GijsJackersPXL/Project_ontwerpen/Foto's/Relay board with LCD (3).jpg

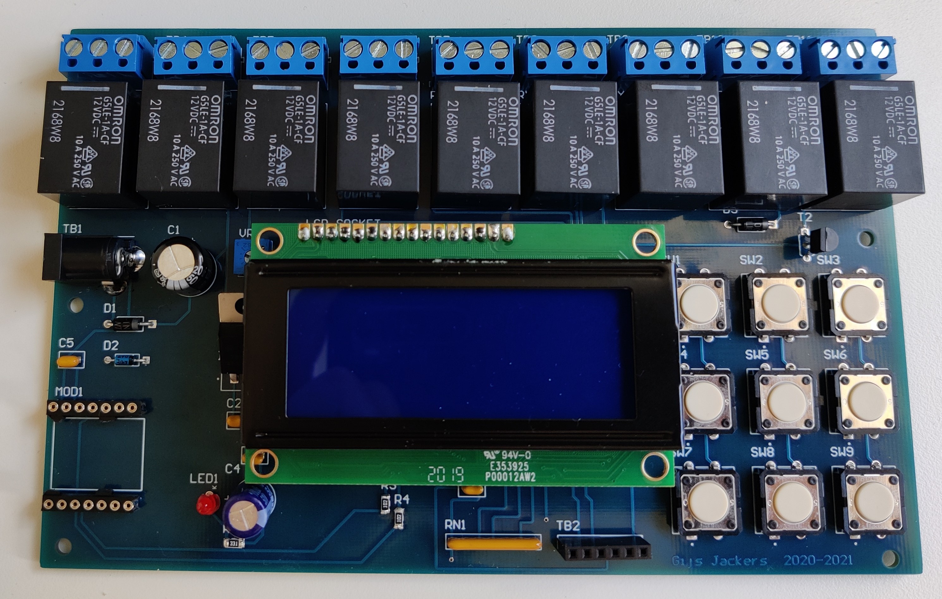
Foto's/Relay board with LCD (3).jpg
