GijsJackersPXL/Project_ontwerpen/Foto's/Relay board with LCD (2).jpg

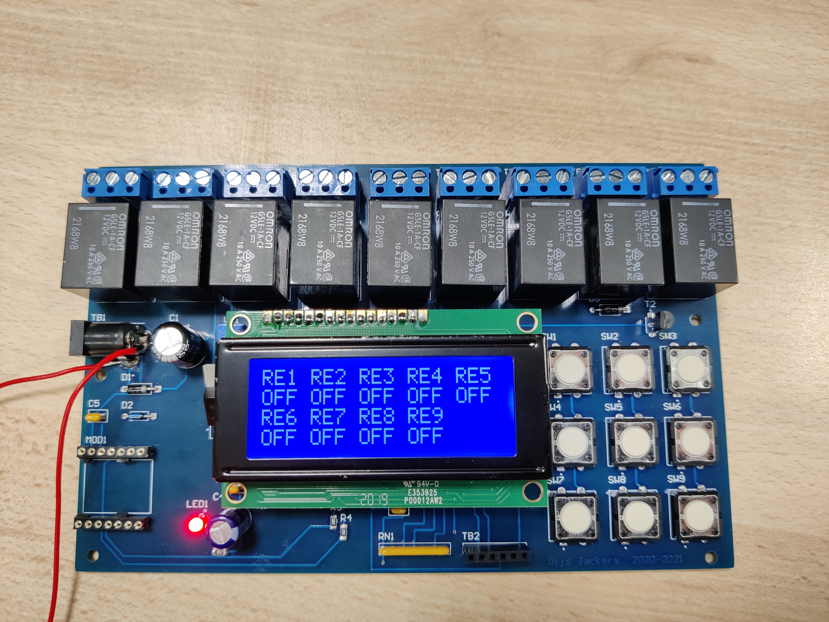
Foto's/Relay board with LCD (2).jpg
