GijsJackersPXL/Project_ontwerpen/README.md

# Project_ontwerpen

Korte uitleg:
- De printplaat is een 9 kanaal relais bord waarbij elke relais apart bedienbaar is met zijn samenhangende knop. De status van iedere relais is zichtbaar op het LCD scherm.
