GijsJackersPXL/Project_ontwerpen/Foto's/Elektrisch schema.png

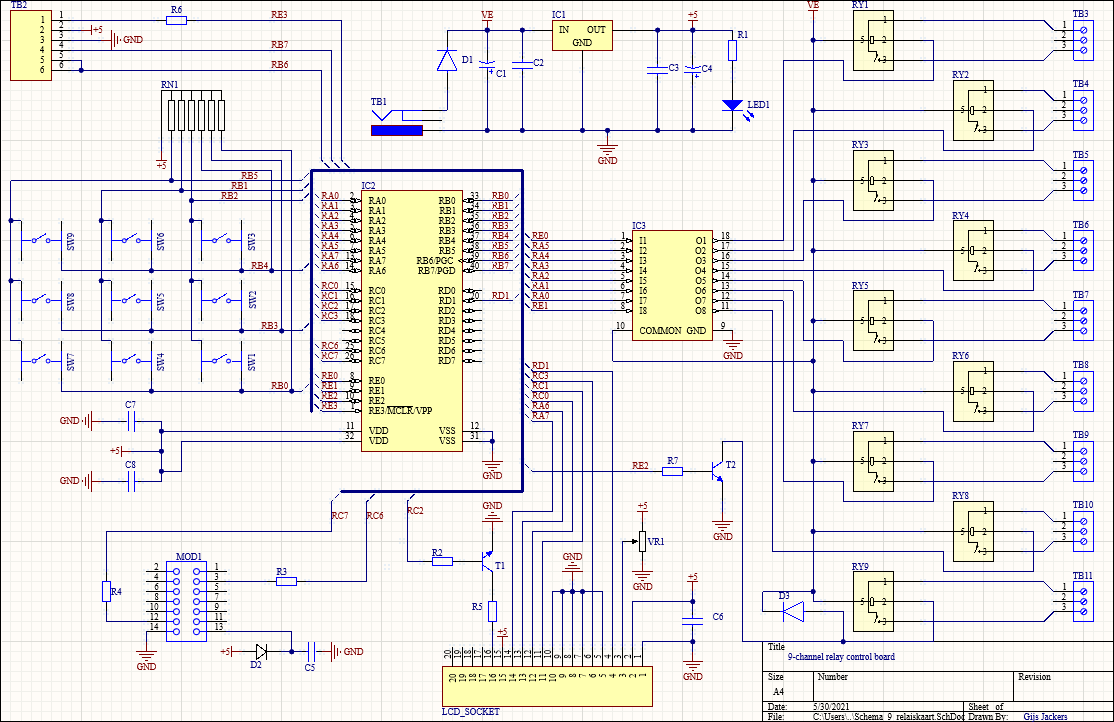
Foto's/Elektrisch schema.png
