GijsJackersPXL/Project_ontwerpen/Foto's/LCD display of relay board.jpg

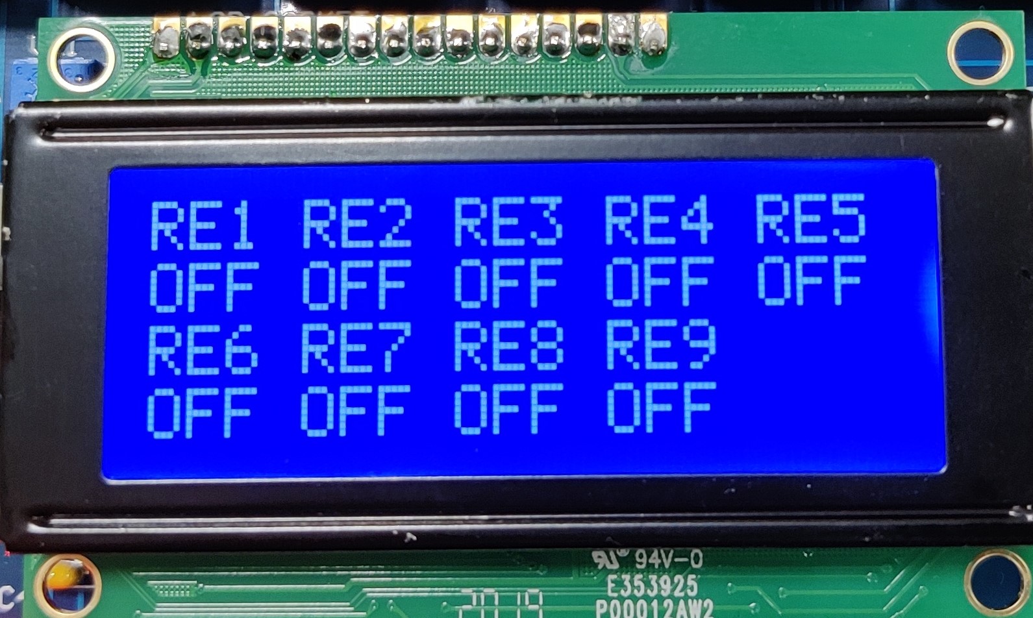
Foto's/LCD display of relay board.jpg
