GijsJackersPXL/Project_ontwerpen/Foto's/Relay board with LCD (1).jpg

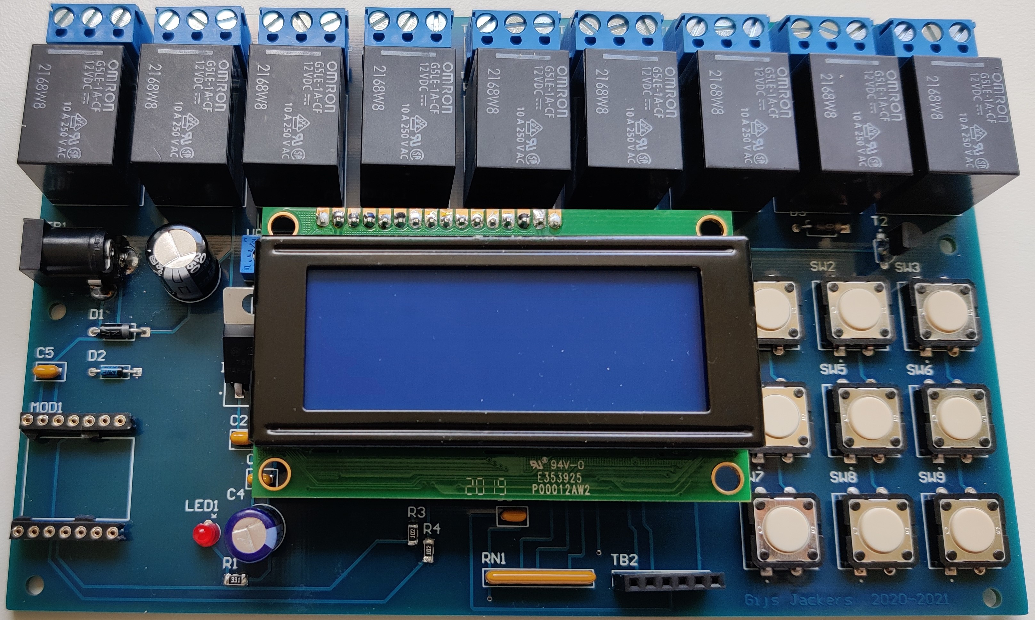
Foto's/Relay board with LCD (1).jpg
