GijsJackersPXL/Project_ontwerpen/BOM/Bill of Materials.xlsx

Number of items | Part number | Component number | Description | Unit price | Total cost | Supplier | Delivery date |  |  |  |  | Subtotaal | 89.69 €
2 | P330ECT-ND | ERJ-8GEYJ331V | RES SMD 330 OHM 5% 1/4W 1206 | 0.08 | 0.16 € | Digi-Key | 2021-03-19 | 4 | 2 | 0.32 € | 2
1 | PIC18F45K22-E/P-ND | PIC18F45K22-E/P | IC MCU 8BIT 32KB FLASH 40DIP | 3.05 | 3.05 € | Digi-Key | 2021-03-19 | 2 | 2 | 6.10 € | 2
9 | Z12704-ND | G5LE-1A-CF DC12 | RELAY GEN PURPOSE SPST 10A 12V | 1.092 | 9.83 € | Digi-Key | 2021-03-19 | 18 | 2 | 19.66 € | 2
1 | 952-2538-ND | D01-9972042 | CONN SOCKET SIP 20POS GOLD | 1.3 | 1.30 € | Digi-Key | 2021-03-19 | 2 | 2 | 2.60 € | 2
1 | 497-2356-5-ND | ULN2803A | TRANS 8NPN DARL 50V 0.5A 18DIP | 1.1 | 1.10 € | Digi-Key | 2021-03-19 | 2 | 2 | 2.20 € | 2 |  | 30.37 €
3 | P4.7KECT-ND | ERJ-8GEYJ472V | RES SMD 4.7K OHM 5% 1/4W 1206 | 0.08 | 0.24 € | Digi-Key | 2021-03-19 | 6 | 2 | 0.48 € | 2 |  | 1.42
3 | P1.0KECT-ND | ERJ-8GEYJ102V | RES SMD 1K OHM 5% 1/4W 1206 | 0.08 | 0.24 € | Digi-Key | 2021-03-19 | 6 | 2 | 0.48 € | 2
2 | P10ECT-ND | ERJ-8GEYJ100V | RES SMD 10 OHM 5% 1/4W 1206 | 0.08 | 0.16 € | Digi-Key | 2021-03-19 | 4 | 2 | 0.32 € | 2
2 | P4.7ECT-ND | ERJ-8GEYJ4R7V | RES SMD 4.7 OHM 5% 1/4W 1206 | 0.08 | 0.16 € | Digi-Key | 2021-03-19 | 4 | 2 | 0.32 € | 2
1 | 4607X-101-103LF | 4607X-101-103LF | RES ARRAY 6 RES 10K OHM 7SIP | 0.53 | 0.53 € | Digi-Key | 2021-03-19 | 2 | 2 | 1.06 € | 2
2 | ECA1HM101 | ECA-1HM101 | CAP ALUM 100UF 20% 50V RADIAL | 0.28 | 0.56 € | Digi-Key | 2021-03-19 | 4 | 2 | 1.12 € | 2
2 | 497-2492-1-ND | BAT43 | DIODE SCHOTTKY 30V 200MA DO35 | 0.3 | 0.60 € | Digi-Key | 2021-03-19 | 4 | 2 | 1.20 € | 2
1 | MC7805CTGOS-ND | MC7805CTG | IC REG LINEAR 5V 1A TO220AB | 0.37 | 0.37 € | Digi-Key | 2021-03-19 | 2 | 2 | 0.74 € | 2
2 | BC547BFS-ND | BC547B | TRANS NPN 45V 0.1A TO-92 | 0.38 | 0.76 € | Digi-Key | 2021-03-19 | 4 | 2 | 1.52 € | 2
2 | 732-5005-ND | 151031SS04000 | LED RED DIFFUSED 3MM ROUND T/H | 0.14 | 0.28 € | Digi-Key | 2021-03-19 | 4 | 2 | 0.56 € | 2
9 | 732-2027-ND | 691102000000 | TERM BLK 3POS SIDE ENTRY 5MM PCB | 0.711 | 6.40 € | Digi-Key | 2021-03-19 | 18 | 2 | 12.80 € | 2
9 | SW411-ND | B3F-4000 | SWITCH TACTILE SPST-NO 0.05A 24V | 0.351 | 3.16 € | Digi-Key | 2021-03-19 | 18 | 2 | 6.32 € | 2
1 | 952-1809-ND | M20-7820646 | CONN RCPT 6POS 0.1 TIN PCB | 0.84 | 0.84 € | Digi-Key | 2021-03-19 | 2 | 2 | 1.68 € | 2
7 | 478-3187-ND | SR205C104KAR | CAP CER 0.1UF 50V X7R RADIAL | 0.368 | 2.58 € | Digi-Key | 2021-03-19 | 14 | 2 | 5.15 € | 2
2 | P5572-ND | ECA-1HHG221 | CAP ALUM 220UF 20% 50V RADIAL | 0.5 | 1.00 € | Digi-Key | 2021-03-19 | 4 | 2 | 2.00 € | 2
1 | 3362P-103LF-ND | 3362P-1-103LF | TRIMMER 10K OHM 0.5W PC PIN TOP | 0.85 | 0.85 € | Digi-Key | 2021-03-19 | 2 | 2 | 1.70 € | 2
1 | 1568-1720-ND | BOB-13263 | SPARKFUN FT231X BREAKOUT | 10.68 | 10.68 € | Digi-Key | 2021-03-19 | 2 | 2 | 21.36 € | 2
5 | 2227MC-18-03-08-F1 | 2227MC-18-03-08-F1 | OCKET IC, DIL, 0.3",18WAY MULTICOMP | 0.97 | 4.85 € | Sinuss | 2021-03-22
1 | 2227MC-40-06-05-F1 | 2227MC-40-06-05-F1 | SOCKET IC, DIL, 0.6",40WAY MULTICOMP | 2.18 | 2.18 € | Sinuss | 2021-03-22
5 | 1N4007 | 1N4007 | OWER RECTIFIER, 1000V,DO-41 NTE ELECTRONICS | 0.31 | 1.55 € | Sinuss | 2021-03-22
1 | RA-T2X-25E | RA-T2X-25E | TO-220/218/247,BLACK OHMITE | 2.85 | 2.85 € | Sinuss | 2021-03-22
1 | MC42004A6WR-BNMLW-V2 | MC42004A6WR-BNMLW-V2 | DISPLAY,ALPHANUMERIC, 20X4, WHITE MIDAS | 18.94 | 18.94 € | Sinuss | 2021-03-22
1 | NEB 21R | NEB 21R | Power supply female | 1.41 | 1.42 | Conrad | 2021-03-17
 |  |  |  |  | 76.64 €
