GijsJackersPXL/Project_ontwerpen/(list of files, drawings)

Other design files:
Altium/PCB_1.PcbDoc
Altium/Schema_9_relaiskaart.SchDoc
