GijsJackersPXL/Project_ontwerpen/Foto's/Foto print altium.png

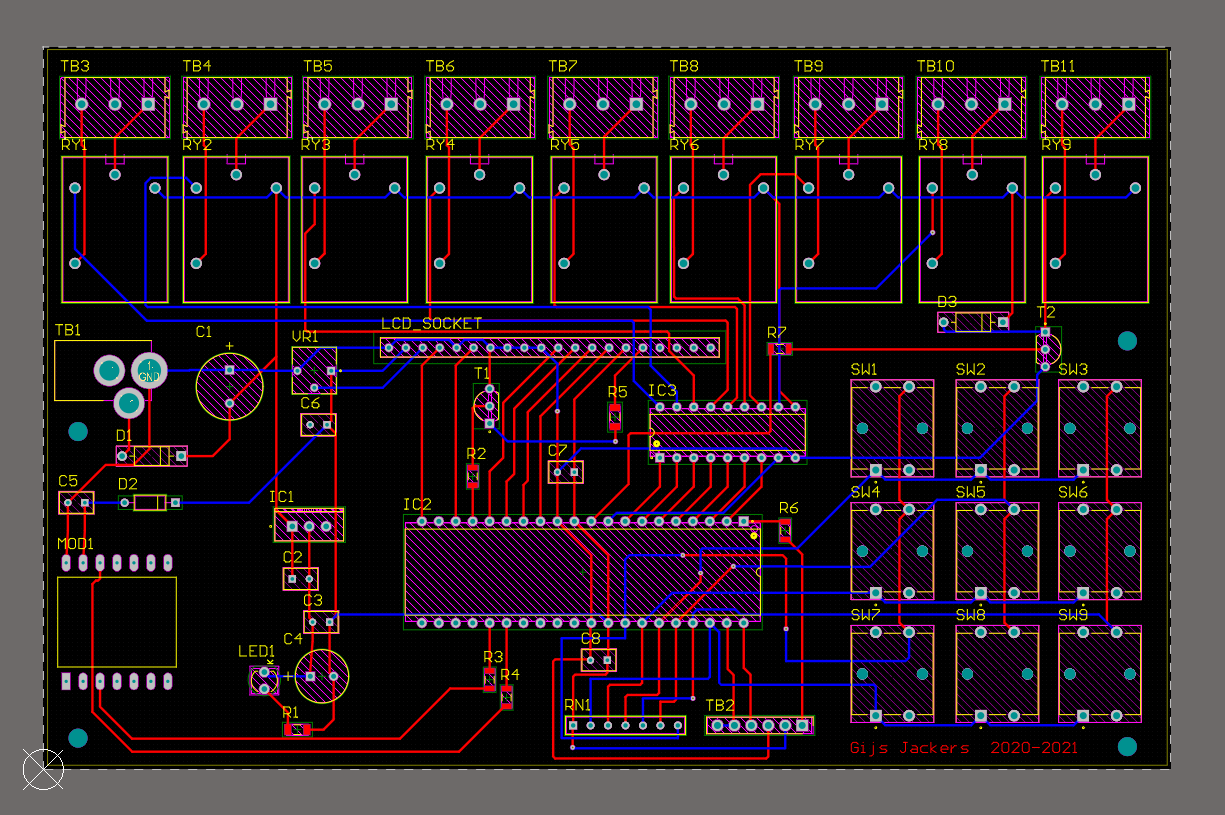
Foto's/Foto print altium.png
